bdelphin/poulailler_auto/images_doc/board_connectors.png

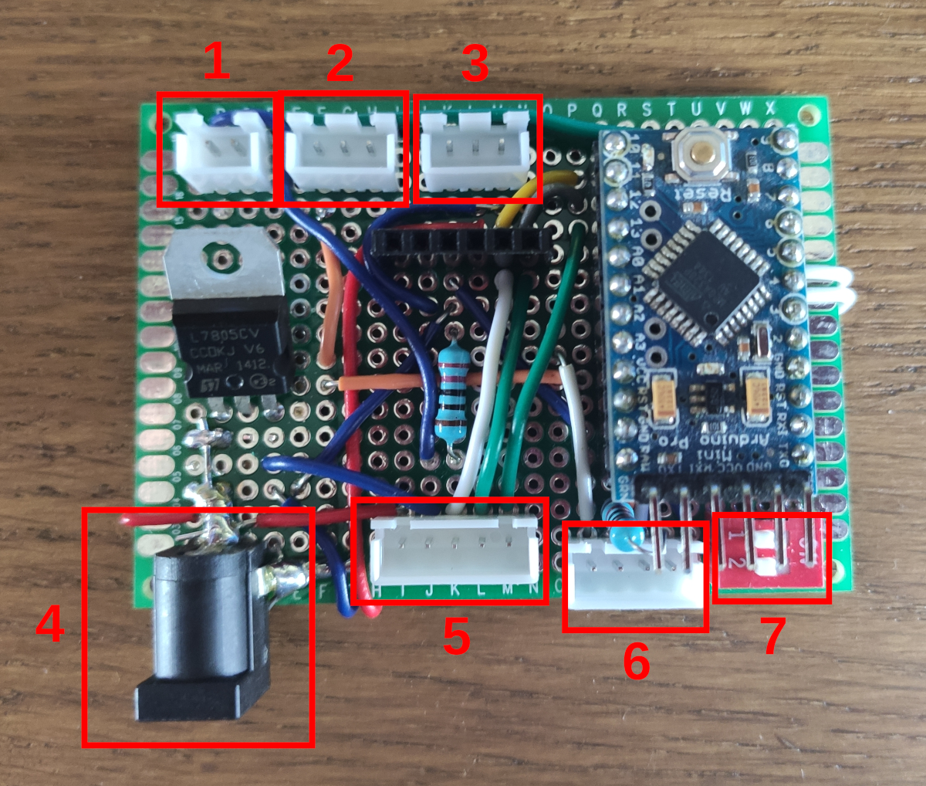
images_doc/board_connectors.png
