bdelphin/poulailler_auto/images_doc/DIP01.png

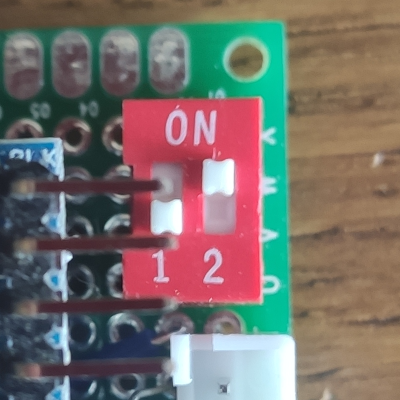
images_doc/DIP01.png
