bdelphin/poulailler_auto/documentation.odt

Documentation : Porte poulailler automatique

Fonctionnement :

La porte s’ouvre et se ferme automatiquement en fonction du soleil.

Dans le mode « normal », la porte s’ouvrira dès que les premiers rayons du soleil seront visibles du poulailler. Il est possible de retarder cette ouverture d’une heure, pour cela voir la section configuration ci-dessous. De la même façon, dès que la luminosité ambiante diminue suffisamment, la porte se fermera. On peut aussi configurer un délai d’une heure pour la retarder la fermeture de la porte, afin d’être sûr qu’aucune poule ne reste coincée dehors.

Le mode normal est désactivé temporairement quand on appuie sur le bouton d’ouverture/fermeture manuelle (voir ci-dessous).

Si un obstacle est présent lors de la fermeture de la porte, elle remontera automatiquement. Elle retentera de se fermer 10 minutes plus tard.

Ouverture/fermeture manuelle :

Un bouton à l’extérieur du poulailler permet de manuellement ouvrir ou fermer la porte. Attention, l’ouverture/fermeture manuelle doit être utilisée « en dernier recours », afin d’éviter que la porte reste ouverte ou fermée lorsqu’elle ne devrait pas l’être.

Comportement de la porte après ouverture/fermeture manuelle :

- Si on ouvre manuellement la porte quand le soleil est levé, elle se fermera automatiquement au coucher du soleil.
- Si on ouvre manuellement la porte quand le soleil est couché, elle ne se fermera automatiquement qu’au prochain coucher de soleil, et restera donc ouverte toute la nuit !
- Si on ferme manuellement la porte alors que le soleil n’est pas couché, elle ne s’ouvrira pas avant le prochain lever de soleil, et restera donc fermée toute la journée !
- Si on ferme manuellement la porte quand le soleil est couché, elle s’ouvrira automatiquement au lever du soleil.

À la prochaine ouverture/fermeture automatique, le système repassera en mode normal.

Configuration :

Sur la carte électronique deux interupteurs (voir photos ci-dessous) permettent de configurer un délai d’une heure pour retarder l’ouverture ou la fermeture de la porte.

Câblage de la carte :

Voici un schéma présentant le câblage de la carte :
