bdelphin/poulailler_auto/images_doc/DIP00.png

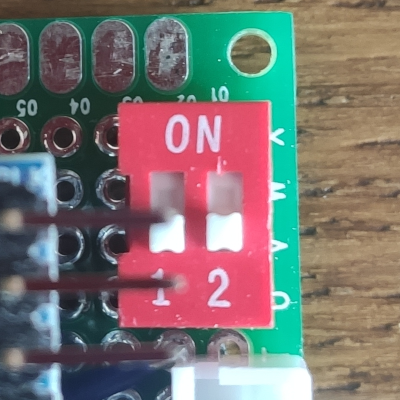
images_doc/DIP00.png
