bdelphin/poulailler_auto/images_doc/DIP10.png

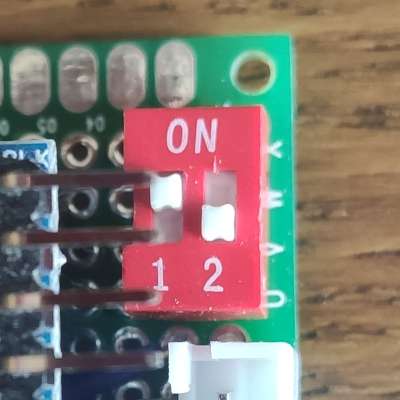
images_doc/DIP10.png
