bdelphin/poulailler_auto/images_doc/DIP11.png

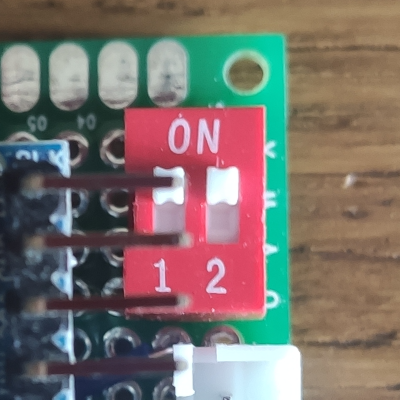
images_doc/DIP11.png
