bdelphin/poulailler_auto/images_doc/l298n_connectors.png

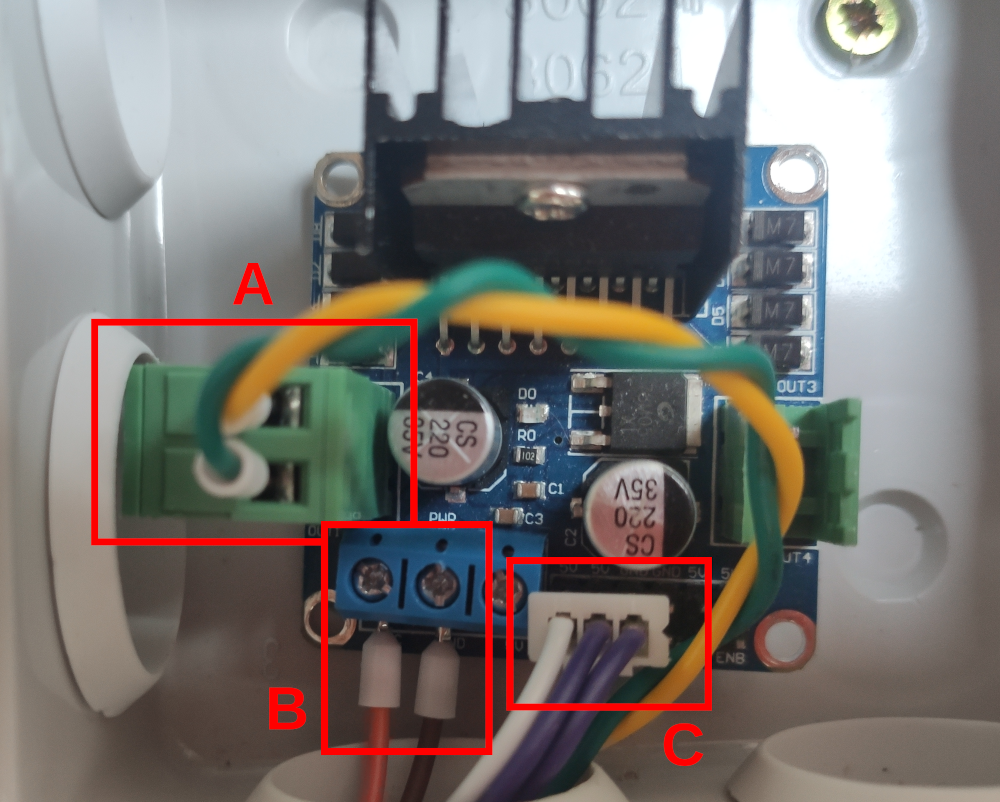
images_doc/l298n_connectors.png
