bdelphin/poulailler_auto/images_doc/led_photores_button.png

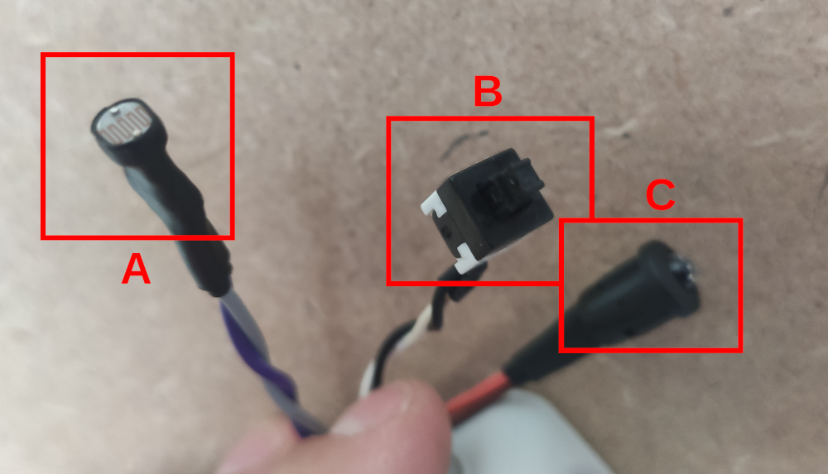
images_doc/led_photores_button.png
