bdelphin/poulailler_auto/PCB_PortePoulailler/PCB_PortePoulailler.kicad_pcb

## KiCad design PCB_PortePoulailler/PCB_PortePoulailler.kicad_pcb (2021-07-24)

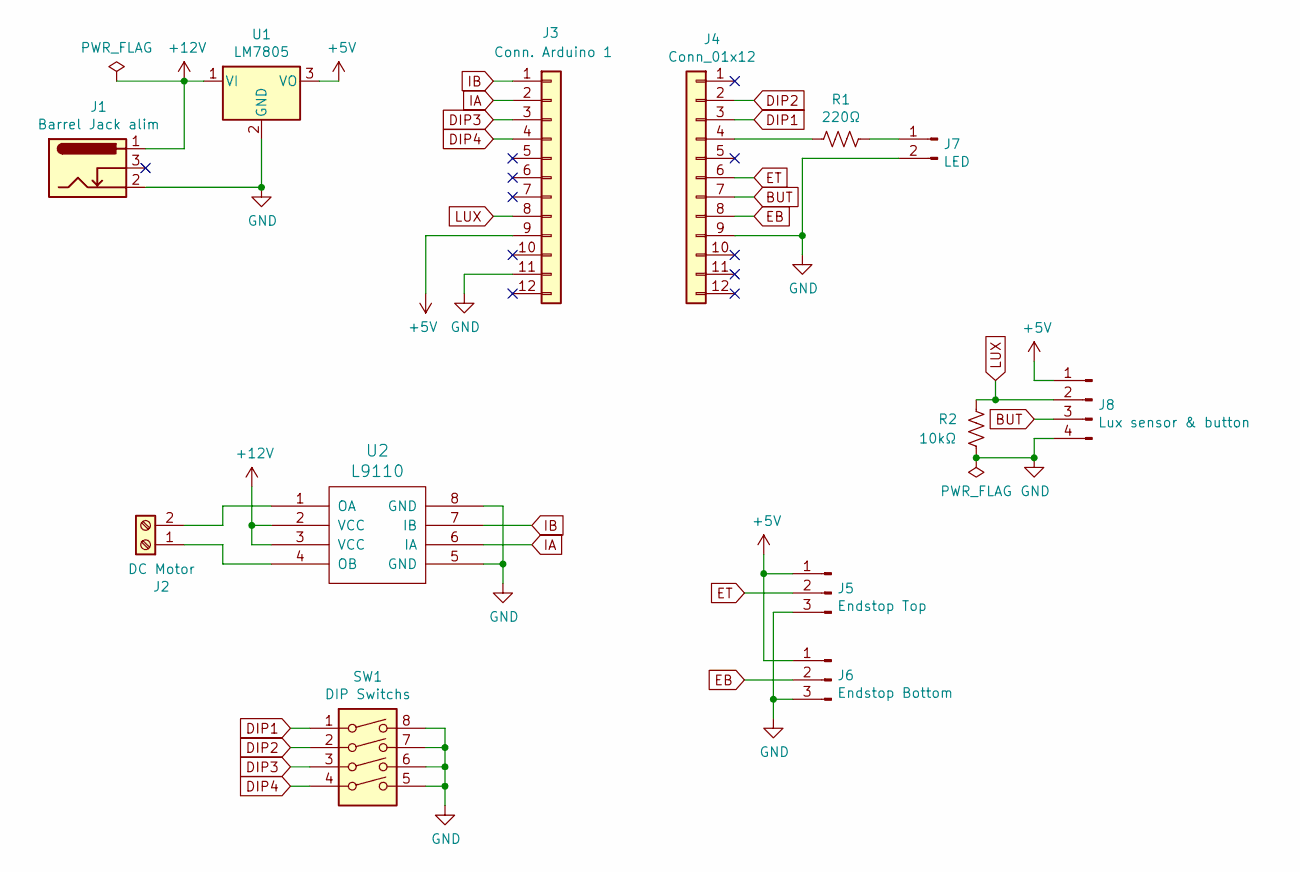
[picture p8: schematic PCB_PortePoulailler.sch, Porte de poulailler automatique avec Arduino]

Parts:
J1: Barrel Jack alim; BarrelJack_Horizontal
J2: DC Motor; TerminalBlock_Altech_AK300-2_P5.00mm
J3: Conn. Arduino 1; PinHeader_1x12_P2.54mm_Vertical
J4: Conn_01x12; PinHeader_1x12_P2.54mm_Vertical
J5: Endstop Top; JST_XH_B3B-XH-A_1x03_P2.50mm_Vertical
J6: Endstop Bottom; JST_XH_B3B-XH-A_1x03_P2.50mm_Vertical
J7: LED; JST_XH_B2B-XH-A_1x02_P2.50mm_Vertical
J8: Lux sensor & button; JST_XH_B4B-XH-A_1x04_P2.50mm_Vertical
R1: 220Ω; R_Axial_DIN0309_L9.0mm_D3.2mm_P12.70mm_Horizontal
R2: 10kΩ; R_Axial_DIN0309_L9.0mm_D3.2mm_P12.70mm_Horizontal
SW1: DIP Switchs; SW_DIP_SPSTx04_Slide_9.78x12.34mm_W7.62mm_P2.54mm
U1: LM7805; TO-220-3_Vertical
U2: L9110; DIP-8_W7.62mm

Connections:
+5V: J3.9, J5.1, J6.1, J8.1, U1.3 (VO)
+12V: J1.1, U1.1 (VI), U2.2 (VCC), U2.3 (VCC)
BUT: J4.7, J8.3
DIP1: J4.3, SW1.1
DIP2: J4.2, SW1.2
DIP3: J3.3, SW1.3
DIP4: J3.4, SW1.4
EB: J4.8, J6.2
ET: J4.6, J5.2
GND: J1.2, J3.11, J4.9, J5.3, J6.3, J7.2, J8.4, R2.2, SW1.5, SW1.6, SW1.7, SW1.8, U1.2 (GND), U2.5 (GND), U2.8 (GND)
IA: J3.2, U2.6 (IA)
IB: J3.1, U2.7 (IB)
LUX: J3.8, J8.2, R2.1
unnamed: J2.1, U2.4 (OB)
unnamed: J2.2, U2.1 (OA)
unnamed: J4.4, R1.1
unnamed: J7.1, R1.2

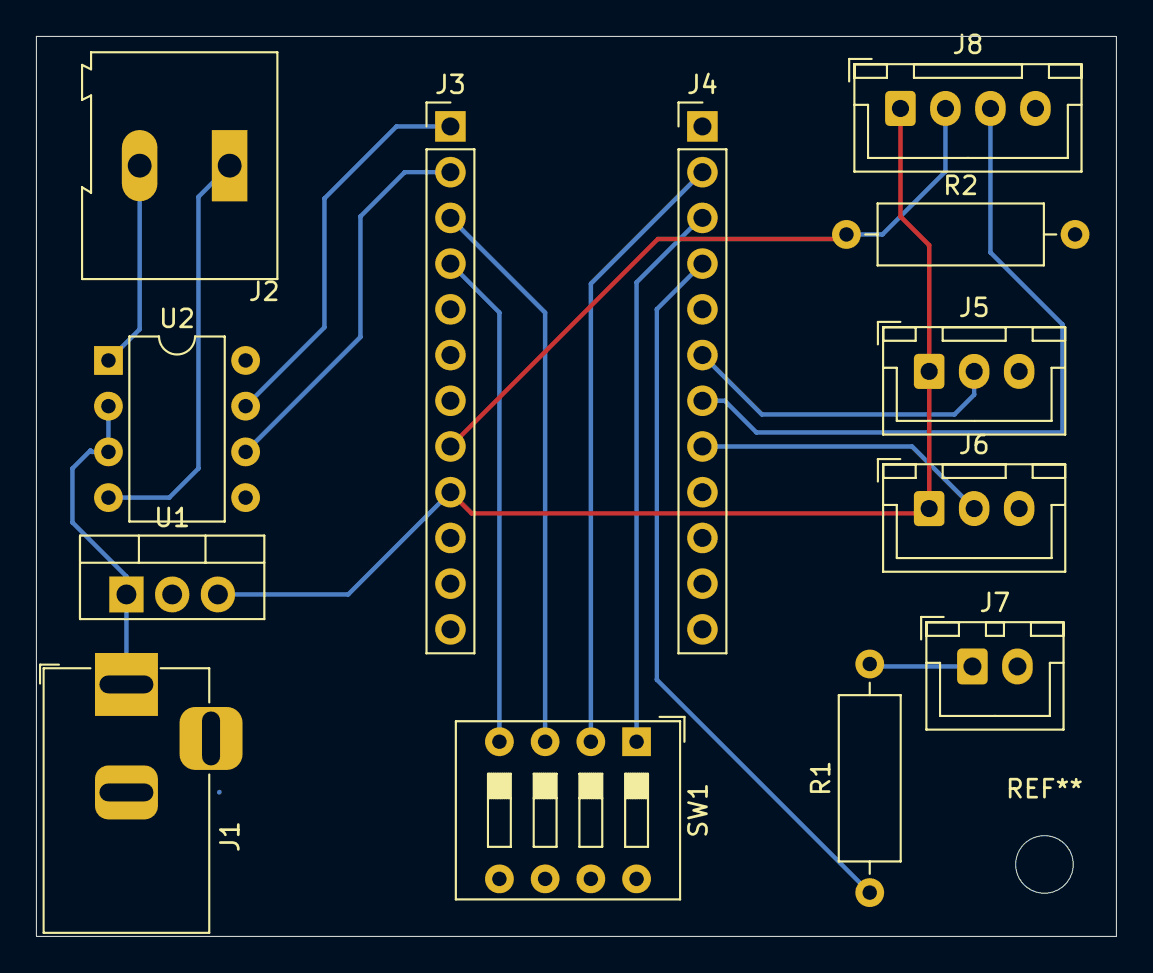
[picture p9: board PCB_PortePoulailler.kicad_pcb from above]

Board: 2 copper layers, 60.0 x 50.0 mm, 13 parts (0 on the bottom side), 17 nets.
