bdelphin/poulailler_auto/(commit log)

2021-07-24 PCB Kicad
    [PCB_PortePoulailler.kicad_pcb, PCB_PortePoulailler.sch]
2021-07-24 sketch arduino
2021-07-24 DIP switch configuration added
2021-07-26 added close crash detection & manual override
    [sketch_arduino_poulailler.ino]
2021-07-27 new motor driver : L298N
